sbina6/Unifi-Sun-shades/v9/fov_overlay.png

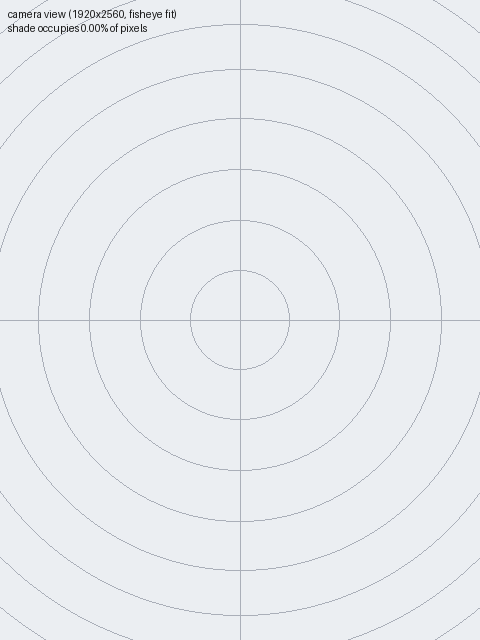
v9/fov_overlay.png
