sbina6/Unifi-Sun-shades/adapter/print_kit/wall_adapter.step

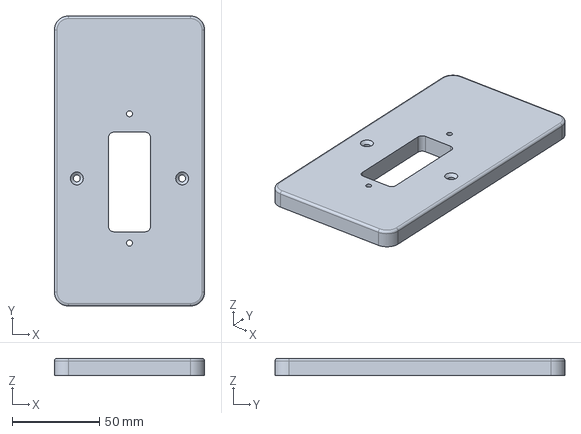
[picture p17: CAD file, 2026-11-07]
adapter/print_kit/wall_adapter.step
86.0 x 166.0 x 10.0 mm
