sbina6/Unifi-Sun-shades/v5a/fit_test_coupon_v5a.step

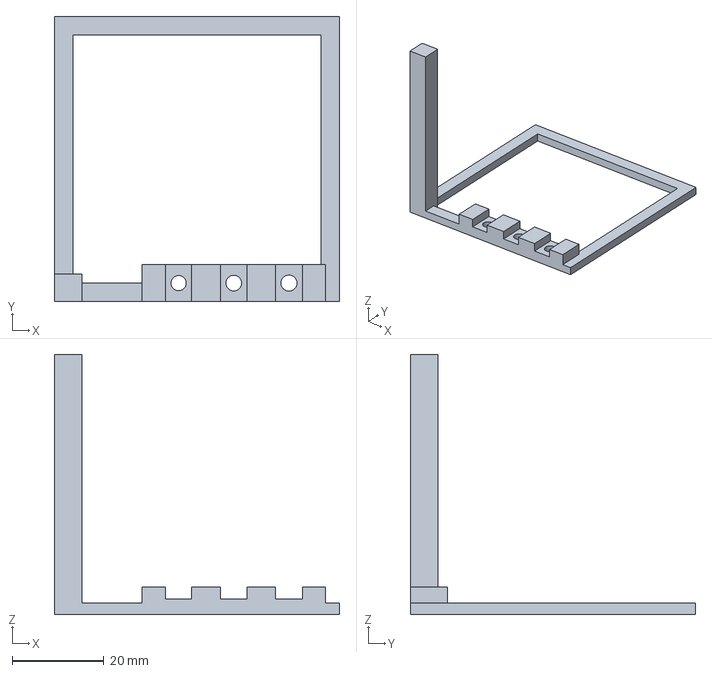
[picture p18: CAD file, 2026-11-08]
v5a/fit_test_coupon_v5a.step
62.0 x 62.0 x 56.6 mm
