sbina6/Unifi-Sun-shades/v9/sunshade_hood_v9.step

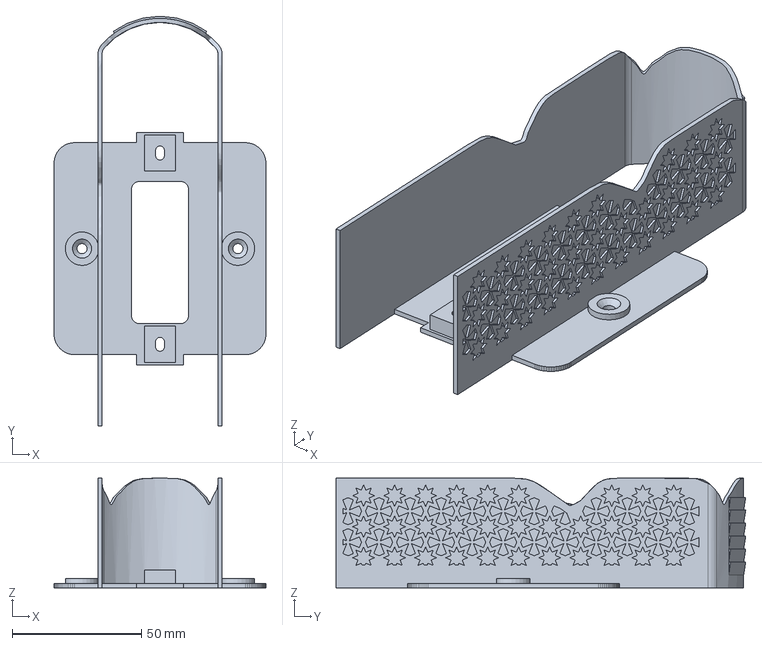
[picture p21: CAD file, 2026-11-08]
v9/sunshade_hood_v9.step
82.0 x 158.4 x 42.4 mm
