sbina6/Unifi-Sun-shades/adapter/print_kit/wall_adapter_TR300.stl

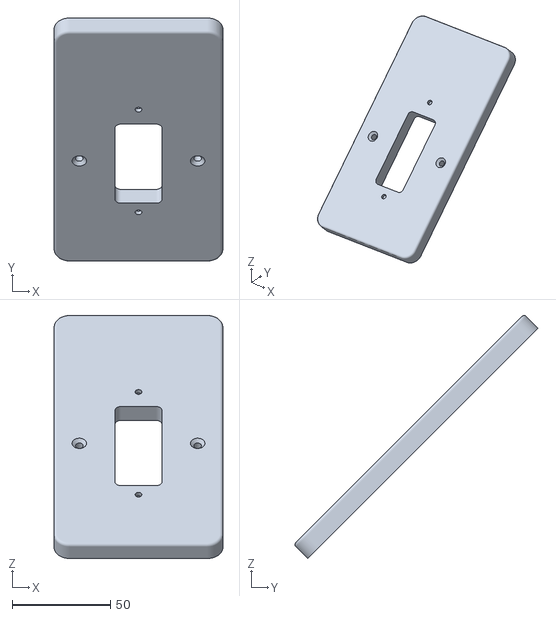
[picture p22: CAD file, 2026-11-07]
adapter/print_kit/wall_adapter_TR300.stl
86.0 x 123.8 x 123.8
