sbina6/Unifi-Sun-shades/v5a/sunshade_hood_v5a.step

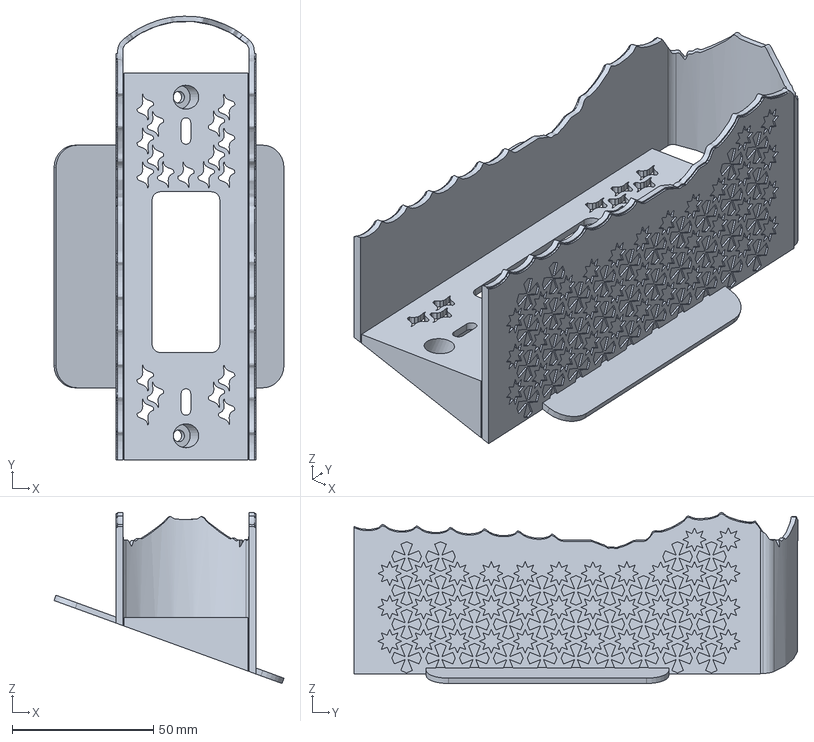
[picture p23: CAD file, 2026-11-08]
v5a/sunshade_hood_v5a.step
81.5 x 157.2 x 60.6 mm
