sbina6/Unifi-Sun-shades/v9/print_kit/designs/shade_smooth_TR300.stl

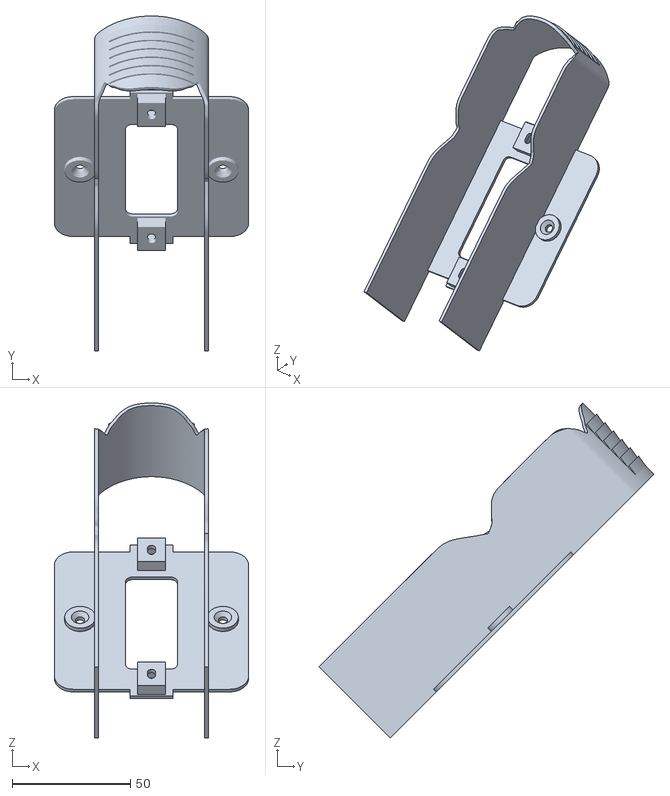
[picture p25: CAD file, 2026-11-08]
v9/print_kit/designs/shade_smooth_TR300.stl
82.0 x 141.4 x 141.4
