sbina6/Unifi-Sun-shades/v9/print_kit/designs/shade_rosette_TR300.stl

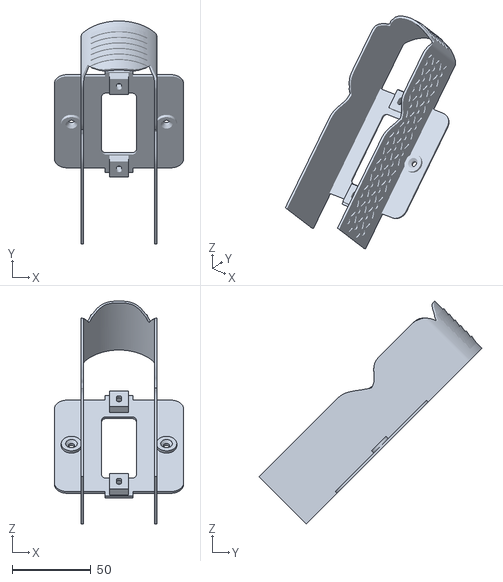
[picture p26: CAD file, 2026-11-08]
v9/print_kit/designs/shade_rosette_TR300.stl
82.0 x 141.4 x 141.4
