sbina6/Unifi-Sun-shades/v5a/print_kit/designs/shade_rosette_scallop_TR300.stl

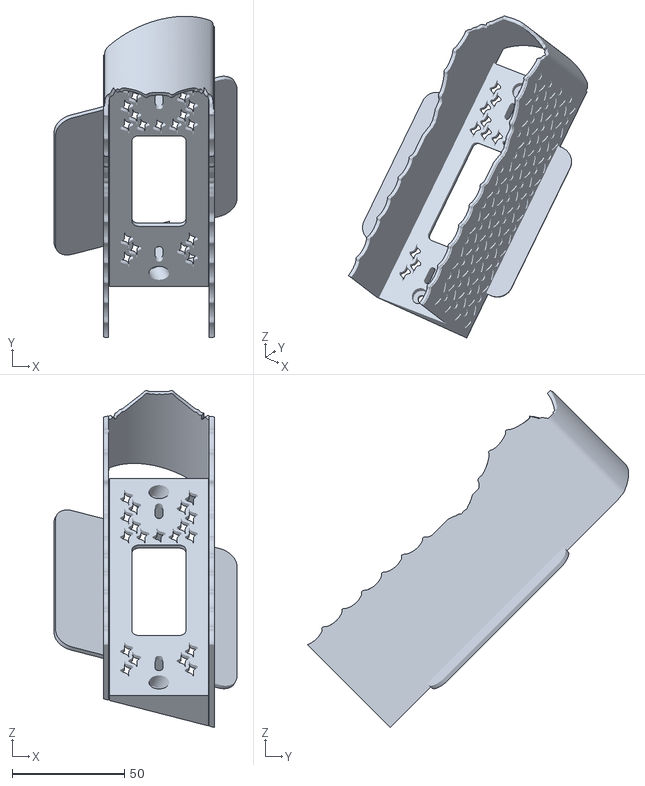
[picture p27: CAD file, 2026-11-08]
v5a/print_kit/designs/shade_rosette_scallop_TR300.stl
81.5 x 143.3 x 150.3
