sbina6/Unifi-Sun-shades/(list of files, cad)

Other CAD files:
v5a/print_kit/sunshade_hood_v5a_TR300.stl
v9/print_kit/sunshade_hood_v9_TR300.stl
v5a/print_kit/designs/shade_octstar_scallop_TR300.stl
v9/fit_test_coupon_v9.step
v9/print_kit/designs/shade_octstar_TR300.stl
v9/print_kit/fit_test_coupon_v9.step
v5a/print_kit/designs/shade_hexstar_scallop_TR300.stl
v9/print_kit/fit_test_coupon_v9_TR300.stl
v9/print_kit/designs/shade_mashrabiya_TR300.stl
v9/print_kit/designs/shade_hexstar_TR300.stl
v9/print_kit/designs/shade_dodecastar_TR300.stl
v1/doorbell_lite_envelope_ref.step
v1/fit_test_coupon_v1.step
v1/print_kit/fit_test_coupon_v1.step
v1/print_kit/sunshade_hood_v1.step
v1/print_kit/sunshade_hood_v1_TR300.stl
v1/sunshade_hood_v1.step
v2/fit_test_coupon_v2.step
v2/print_kit/fit_test_coupon_v2.step
v2/print_kit/fit_test_coupon_v2_TR300.stl
v2/print_kit/sunshade_hood_v2.step
v2/print_kit/sunshade_hood_v2_TR300.stl
v2/sunshade_hood_v2.step
v3/print_kit/sunshade_hood_v3.step
v3/print_kit/sunshade_hood_v3_TR300.stl
v3/sunshade_hood_v3.step
v3/sunshade_v3.step
v4/fit_test_coupon_v4.step
v4/print_kit/fit_test_coupon_v4.step
v4/print_kit/sunshade_hood_v4.step
v4/print_kit/sunshade_hood_v4_TR300.stl
v4/sunshade_hood_v4.step
v6/fit_test_coupon_v6.step
v6/print_kit/designs/shade_hexstar_TR300.stl
v6/print_kit/designs/shade_khatam_TR300.stl
v6/print_kit/designs/shade_octstar_TR300.stl
v6/print_kit/designs/shade_rosette_TR300.stl
v6/print_kit/designs/shade_smooth_TR300.stl
v6/print_kit/fit_test_coupon_v6.step
v6/print_kit/sunshade_hood_v6.step
v6/print_kit/sunshade_hood_v6_TR300.stl
v6/sunshade_hood_v6.step
v7/fit_test_coupon_v7.step
v7/print_kit/designs/shade_hexstar_TR300.stl
v7/print_kit/designs/shade_khatam_TR300.stl
v7/print_kit/designs/shade_octstar_TR300.stl
v7/print_kit/designs/shade_rosette_TR300.stl
v7/print_kit/designs/shade_smooth_TR300.stl
v7/print_kit/fit_test_coupon_v7.step
v7/print_kit/sunshade_hood_v7.step
v7/print_kit/sunshade_hood_v7_TR300.stl
v7/sunshade_hood_v7.step
v8/fit_test_coupon_v8.step
v8/print_kit/designs/shade_arcade_TR300.stl
v8/print_kit/designs/shade_dodecastar_TR300.stl
v8/print_kit/designs/shade_hexstar_TR300.stl
v8/print_kit/designs/shade_khatam_TR300.stl
v8/print_kit/designs/shade_mashrabiya_TR300.stl
v8/print_kit/designs/shade_octstar_TR300.stl
v8/print_kit/designs/shade_rosette_TR300.stl
v8/print_kit/designs/shade_smooth_TR300.stl
v8/print_kit/fit_test_coupon_v8.step
v8/print_kit/sunshade_hood_v8.step
v8/print_kit/sunshade_hood_v8_TR300.stl
v8/sunshade_hood_v8.step
