sbina6/Unifi-Sun-shades/(commit log)

2026-11-06 Add CLAUDE.md with resin-printing design rules and CAD toolchain notes
    Claude-Session: https://claude.ai/code/session_01F3Bt1HPJJVdA4BamsMEjf4
2026-11-06 Add v1 static sunshade for the UniFi Doorbell Lite
    TR300 hood clamped behind the doorbell's mounting plate (flat or 20 deg
    wedge). Includes the build123d model, verification (interference, hook-on
    install sweep, screw paths, camera FOV), oriented STLs with print list and
    manifest, the three.js viewer source, and a README section.
    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
    [doorbell_lite_envelope_ref.step, fit_test_coupon_v1.step, fit_test_coupon_v1_TR300.stl, sunshade_hood_v1.step, sunshade_hood_v1_TR300.stl]
2026-11-06 Add sun study for a 150 deg wall in Doha and v2 sunshade
    Solar path (NOAA) for Doha on five dates, ray-traced against the doorbell
    and shade. v2 builds the side walls and roof 20 mm deep and cuts out the
    camera's view volume (3 deg margin), so it shades every sun direction
    outside the picture and never appears in the video. Includes verification,
    oriented STLs, print list, charts, viewer source and README section.
    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
    [fit_test_coupon_v2.step, fit_test_coupon_v2_TR300.stl, hood.brep.stl, sunshade_hood_v2.step, sunshade_hood_v2_TR300.stl]
2026-11-06 Ignore intermediate brep meshes
    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
    [hood.brep.stl]
2026-11-06 Add v3: one printed part that replaces the 20 deg wedge and shades the doorbell
    The doorbell is turned 20 deg left toward the entrance (camera ~170 deg,
    wall 150 deg). v3 integrates the wedge: back flush to the wall, plate fixed
    with M3x12 countersunk screws into sliding nuts (-1/+5 mm travel). The shell
    is one 2.2 mm cowl with R10 corners and a smooth B-spline lip that follows
    the camera-view limit. Sun model now includes the wall's own shade.
    Adds v3 checks, coupon with nut-channel and hole fits, print kit, charts,
    viewer source and README section; fixes the viewer stage height.
    Claude-Session: https://claude.ai/code/session_01F3Bt1H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
    [fit_test_coupon_v3.step, fit_test_coupon_v3_TR300.stl, sunshade_hood_v3.step, sunshade_hood_v3_TR300.stl, sunshade_v3.step]
2026-11-06 Add v4: car-shade-style sunshade (barrel vault, arched ribs, S-diamond lattice)
    Restyles v3 after the arched car shade beside the doorbell: barrel-vault
    roof with R5 fillets, three raised arched ribs, framed S-diamond lattice
    in relief on the sides (solid, so it still shades). Lip recomputed on the
    arched outline; same wedge, mounting and checks as v3, all passing.
    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
    [fit_test_coupon_v4.step, fit_test_coupon_v4_TR300.stl, sunshade_hood_v4.step, sunshade_hood_v4_TR300.stl]
2026-11-07 Add wall adapter for mounting the Doorbell Lite over a Qatar switch box
    One TR300 part that covers a BS 4662 square switch box (screws to its
    60.3 mm lugs) and carries two captured M3 nuts at the Doorbell Lite's
    74 mm wall-screw spacing, so the flat plate, the 20 deg wedge and the
    v3/v4 sunshades all mount on it. Includes model, verification, print
    kit, three.js viewer, and a CLAUDE.md note on the user's devices.
    Claude-Session: https://claude.ai/code/session_01F3Bt1HygWyi4SYk66w38x2
    [fit_test_coupon_adapter.step, fit_test_coupon_adapter_TR300.stl, wall_adapter.step, wall_adapter_TR300.stl]
2026-11-07 Add v5: sunshade, wedge and switch-box cover in one 57 g part
    v4's shade and the wall adapter merged into one TR300 part that screws to
    the BS 4662 box lugs (one screw hidden inside the wedge, one flush on a
    cover ear). Shell 1.8 mm doubles as the wedge side walls; seat windowed,
    spine and wall-screw bosses removed, lattice relief 0.6. 57.2 g vs 134 g
    for v4 + adapter, same shading as v4 (sun study within 1%), 0% of the
    camera picture covered. Includes checks, sun study, print kit and viewer.
    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
    [fit_test_coupon_v5.step, fit_test_coupon_v5_TR300.stl, sunshade_hood_v5.step, sunshade_hood_v5_TR300.stl, sunshade_v5.step]
2026-11-07 Replace off-centre v5 with two centred one-piece variants
    v5a: v4's shade centred on the switch box on a symmetric 86 x 86 mm
    backplate, fixed with the kit's 2 wall screws in new holes 60 mm above
    and below the box (hidden under the plate). 58.0 g, shades like v4.
    v5b: hood redesigned to the box's size (86 mm wide, side walls square to
    the wall, lip cut to the camera picture along the wall normal), fixed
    with the box's own screws inside the hood. 70.0 g, shades less than v4.
    Both: 0% of the camera picture, hook-on clear, all screw/driver/cable
    paths clear, box hidden. Includes sun studies, kits and a two-variant
    viewer. The exporter can orient a part in the wall frame.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
    [fit_test_coupon_v5a.step, fit_test_coupon_v5a_TR300.stl, fit_test_coupon_v5b.step, fit_test_coupon_v5b_TR300.stl, sunshade_hood_v5.step, sunshade_hood_v5_TR300.stl, sunshade_hood_v5a.step, sunshade_hood_v5a_TR300.stl]
2026-11-08 v5a: Islamic geometric patterns, M3 nut pockets and kit-screw wall mounting; drop v5b and the car-shade look
    Shade A only. Side walls carry 0.6 mm relief in one of five patterns
    (8-point star, 6-point star, rosette, octagon and star, smooth) with an
    optional scalloped edge; the car-shade ribs and its reference image are
    gone. Mounting is two separate joints: the doorbell kit's screws into 2
    new wall holes (counterbore d8.5, hole d4.2), and 2 x M3 into nut pockets
    for the doorbell plate. Checks extended (nut insertion from the wall
    side, kit screws at d4 with d8 heads); all pass. Ready-to-print STLs for
    every pattern, a shade designer viewer with a white doorbell and grey
    shade, and an update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
    [fit_test_coupon_v5a.step, fit_test_coupon_v5a_TR300.stl, fit_test_coupon_v5b.step, fit_test_coupon_v5b_TR300.stl, shade_hexstar_scallop_TR300.stl, shade_khatam_scallop_TR300.stl, shade_octstar_scallop_TR300.stl, shade_rosette_scallop_TR300.stl]
2026-11-08 v6: straight shade, box screws left and right, nut pockets for the user's own angled bracket
    The shade is now square to the wall, 76 mm wide and symmetric, with an
    86 mm backplate. It is fixed with the switch box's own 2 screws, left and
    right of the box (no drilling); the walls stand outside both screws. The
    doorbell sits angled inside on the user's own bracket, bolted with M3 into
    2 nut pockets 74 mm apart. No wedge in the printed part. Islamic relief in
    five patterns (STL for each). Lip recomputed along the wall normal against
    the camera picture (0% covered), robust lip cut with a print-resolution
    mesh check. Checks, sun study, kit, and the shade designer updated.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
    [fit_test_coupon_v6.step, fit_test_coupon_v6_TR300.stl, shade_hexstar_TR300.stl, shade_khatam_TR300.stl, shade_octstar_TR300.stl, shade_rosette_TR300.stl, shade_smooth_TR300.stl, sunshade_hood_v6.step]
2026-11-08 v7: simple version, small shade with no angle, nut pockets for the doorbell plate
    A 48 mm shade hugging the flat doorbell on an 86 mm backplate, fixed with
    the switch box's own 2 screws left and right (the shade is narrow enough
    to stand between them). The doorbell's own plate bolts on with M3 x 8
    into 2 nut pockets 74 mm apart (6.8 mm backplate gives the nuts room).
    Five Islamic patterns with STLs; 56.7 g default. All checks pass
    (hook-on clear after raising the roof gap to 19 mm, 0% of the camera
    picture covered, 36 clear screw/nut/driver paths); sun study, kit and
    viewer included.
    Claude-Session: https://claude.ai/code/session_01F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
    [fit_test_coupon_v7.step, fit_test_coupon_v7_TR300.stl, shade_hexstar_TR300.stl, shade_khatam_TR300.stl, shade_octstar_TR300.stl, shade_rosette_TR300.stl, shade_smooth_TR300.stl, sunshade_hood_v7.step]
2026-11-08 v8: thin back flap, nut holders, engraved patterns, three new Islamic designs
    Simple version with a 1.6 mm solid back flap (was a 6.8 mm hollow plate)
    and two raised nut holders (12 x 14 mm, M3 pocket under a 2.0 mm skin,
    nut dropped in from behind through a flap window) so the doorbell plate
    still sits 6.8 mm from the wall. The pattern is now ENGRAVED 0.8 mm into
    the 1.6 mm side walls, so it removes material: 36.0 g with the 8-point
    star against 56.7 g in v7 and 38.2 g smooth. New designs: 12-point star,
    pointed arches, mashrabiya (eight in all, STL for each). Mounting
    unchanged (box screws left and right; M3 x 8 into the holders). All
    checks pass; viewer, kit and docs updated.
    Co-Authored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
    [fit_test_coupon_v8.step, fit_test_coupon_v8_TR300.stl, shade_arcade_TR300.stl, shade_dodecastar_TR300.stl, shade_hexstar_TR300.stl, shade_khatam_TR300.stl, shade_mashrabiya_TR300.stl, shade_octstar_TR300.stl]
2026-11-08 v9: patterns over the whole side faces, stepped roof design
    The engraved pattern now runs over the whole face of both side walls
    (clipped at a 2.6 mm frame, slivers dropped) instead of a band down the
    middle, and the pointed-arch design gets a small round window above each
    arch. The roof carries a subtle stepped design (two rows of stepped
    pyramids, 0.5 mm deep). 34.3 g with the 8-point star (36.0 g in v8). All
    checks pass; kit with eight designs, viewer with a roof switch and a top
    view, and docs updated.
    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
    [fit_test_coupon_v9.step, fit_test_coupon_v9_TR300.stl, shade_arcade_TR300.stl, shade_dodecastar_TR300.stl, shade_hexstar_TR300.stl, shade_khatam_TR300.stl, shade_mashrabiya_TR300.stl, shade_octstar_TR300.stl]
2026-11-08 v9: shingle lines across the roof instead of stepped blocks
    Six straight lines run across the barrel roof from one side of the arch
    to the other, like the courses of a shingled roof: 4.8 mm apart, 0.9 mm
    wide, 0.5 mm deep. They replace the stepped pyramids. Checks still pass;
    kit, all eight designs, viewer (Shingles/Plain switch) and docs updated.
    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
    [shade_arcade_TR300.stl, shade_dodecastar_TR300.stl, shade_hexstar_TR300.stl, shade_khatam_TR300.stl, shade_mashrabiya_TR300.stl, shade_octstar_TR300.stl, shade_rosette_TR300.stl, shade_smooth_TR300.stl]
2026-11-08 v9: raised, overlapping shingle courses on the roof
    The roof now carries six shingle courses built up on the barrel roof
    (thin wedges that rise to 0.8 mm at their front edges and step back
    down, so each overlaps the next), replacing the engraved lines. About
    0.7 g added; the last course ends 3 mm short of the roof edge. Checks
    still pass (hook-on clear, 0% of the camera picture covered, 36 clear
    paths); kit with eight designs, viewer and docs updated. The side
    patterns stay engraved.
    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
    [shade_arcade_TR300.stl, shade_dodecastar_TR300.stl, shade_hexstar_TR300.stl, shade_khatam_TR300.stl, shade_mashrabiya_TR300.stl, shade_octstar_TR300.stl, shade_rosette_TR300.stl, shade_smooth_TR300.stl]
